hamdan-basharat/ToFEnvironmentMapper/README.md

# ToFEnvironmentMapper
A Time-Of-Flight Environment Mapper is an embedded spatial measurement system that uses time-of flight to acquire information about the area around it and visualizes this data through an associated 3D rendering software.
Created on 04-13-2020
