hamdan-basharat/ToFEnvironmentMapper/1-ProjectReport_BASHAM1.pdf

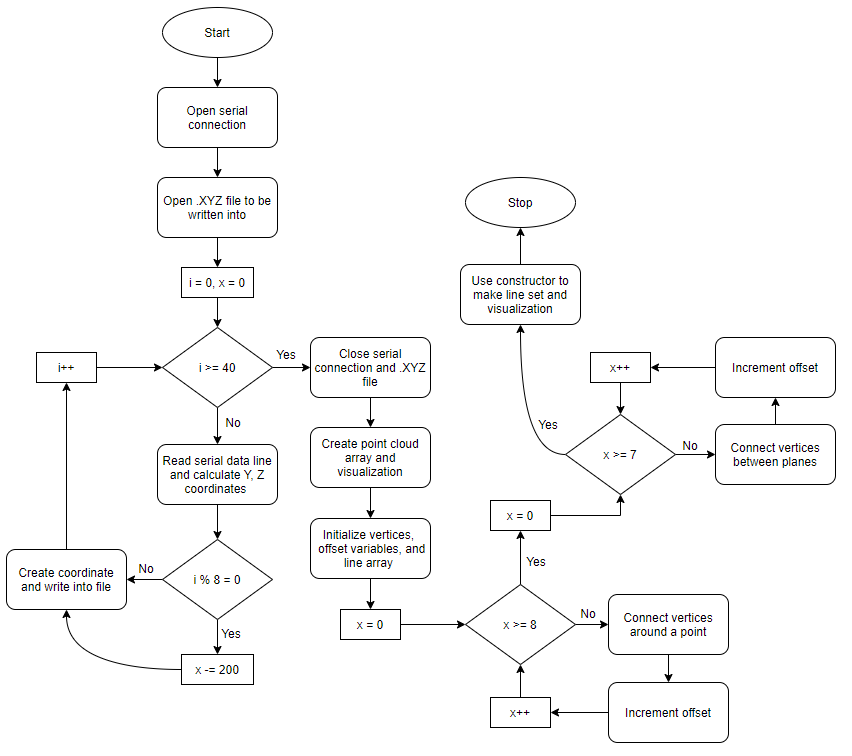
[picture p7: figure]
